BourgeoisLab/MidiCentral/README.md

# MIDI Central
Microcontroller based device to centralize MIDI messages.

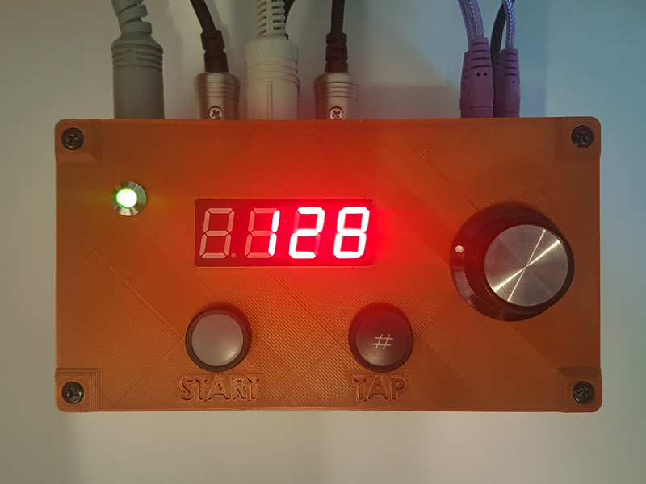
[picture p1: images/01.jpg]
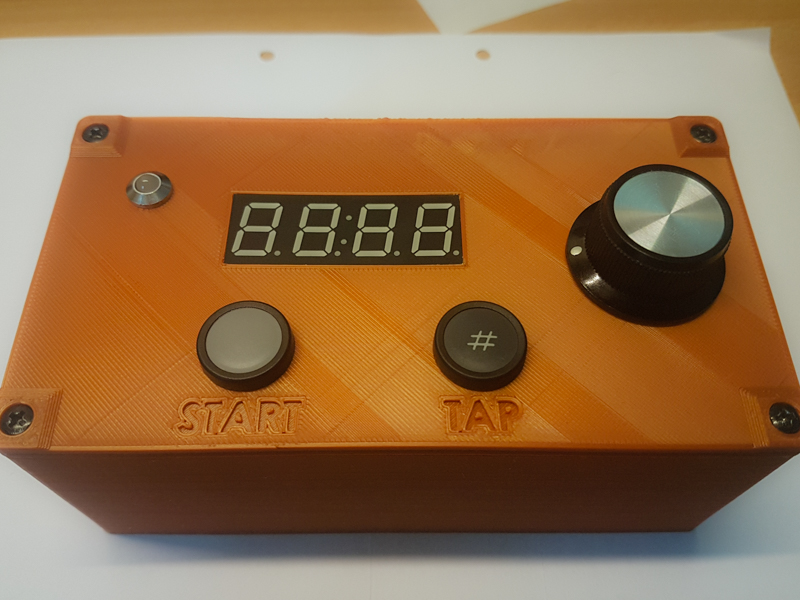
[picture p2: images/02.jpg]
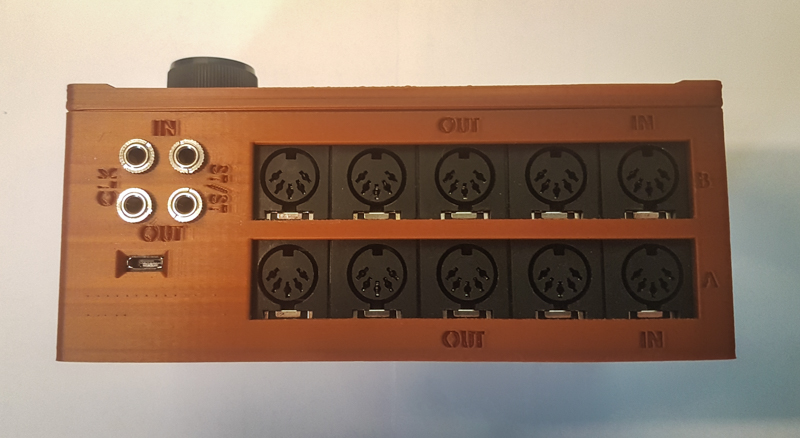
[picture p3: images/03.jpg]
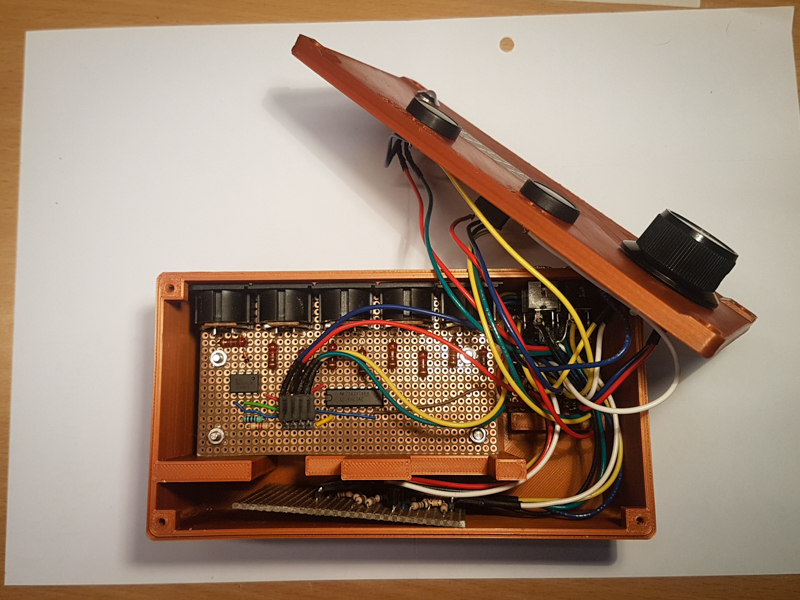
[picture p4: images/04.jpg]
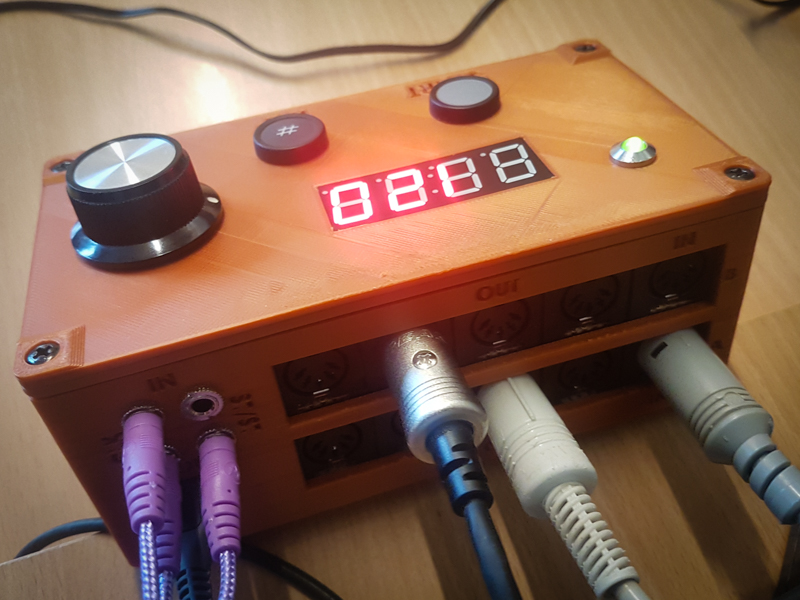
[picture p5: images/05.jpg]


## Features
### Software
- Arduino based code
- Merges up to 3 different MIDI inputs
- MIDI to CV clock converter and vice versa
- Act as a MIDI device when plugged in a computer

### Hardware
- 2x MIDI inputs
- 8x MIDI outputs
- 1x CV clock input and output
- 1x CV start/stop input and output
- 1x start/stop button
- 1x tap button
- 1x encoder
- 1x 4-Digit 7-Segment Display
- Teensy 3.2 (32 bit ARM Cortex-M4 72 MHz CPU)
- USB powered
