BourgeoisLab/MidiCentral/schematics/pinout.png

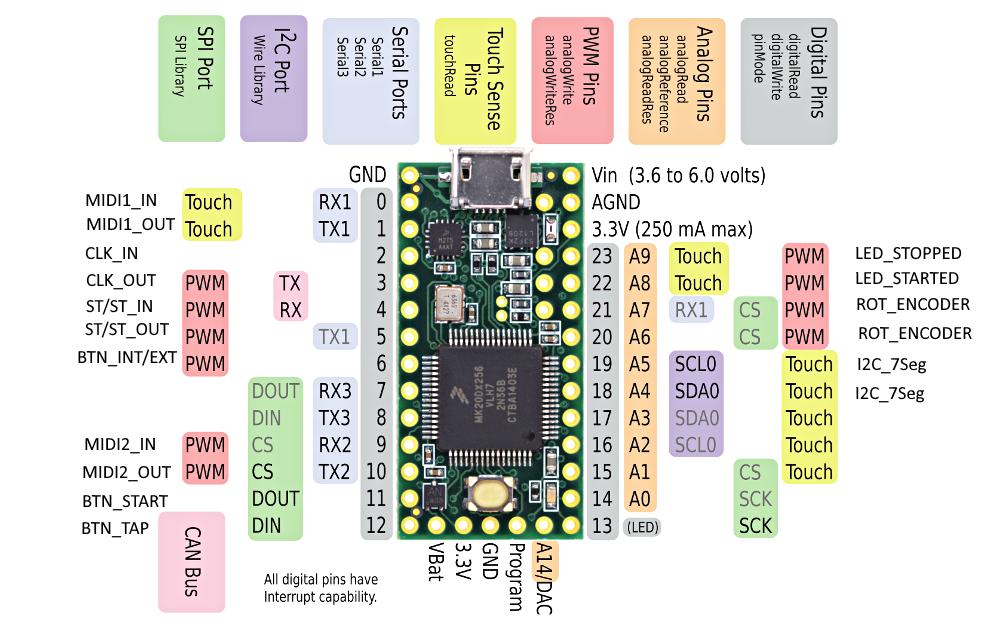
schematics/pinout.png
