BourgeoisLab/MidiCentral/schematics/GateInterface.pdf

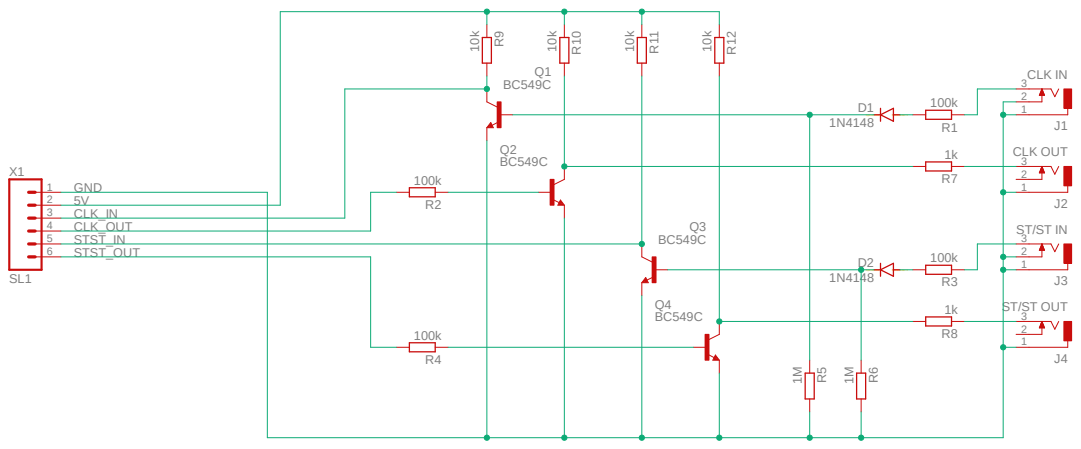
[picture p7: page 1]

Document Number: | REV:

Date: 23.12.2019 15:04 | Sheet: 1/1

23.12.2019 15:05 D:\Downloads\midi\doc\GateInterface.sch (Sheet: 1/1)
