BourgeoisLab/MidiCentral/schematics/MidiInterface.pdf

23.12.2019 15:05 D:\Downloads\midi\doc\MidiInterface.sch (Sheet: 1/1) | SpiceOrder 1 SpiceOrder 2

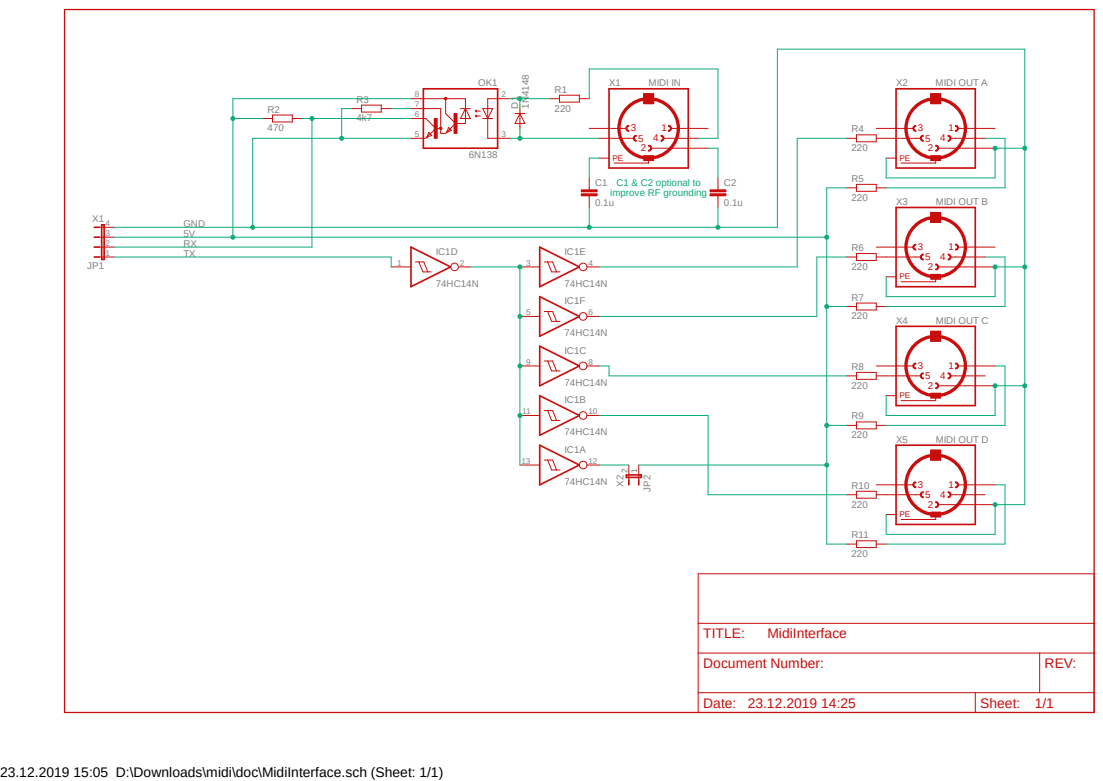
[picture p8: page 1]

Document Number: | REV:

Date: 23.12.2019 14:25 | Sheet: 1/1
