BourgeoisLab/MidiCentral/schematics/GateInterface.sch

## EAGLE design schematics/GateInterface.sch (2020-04-12)

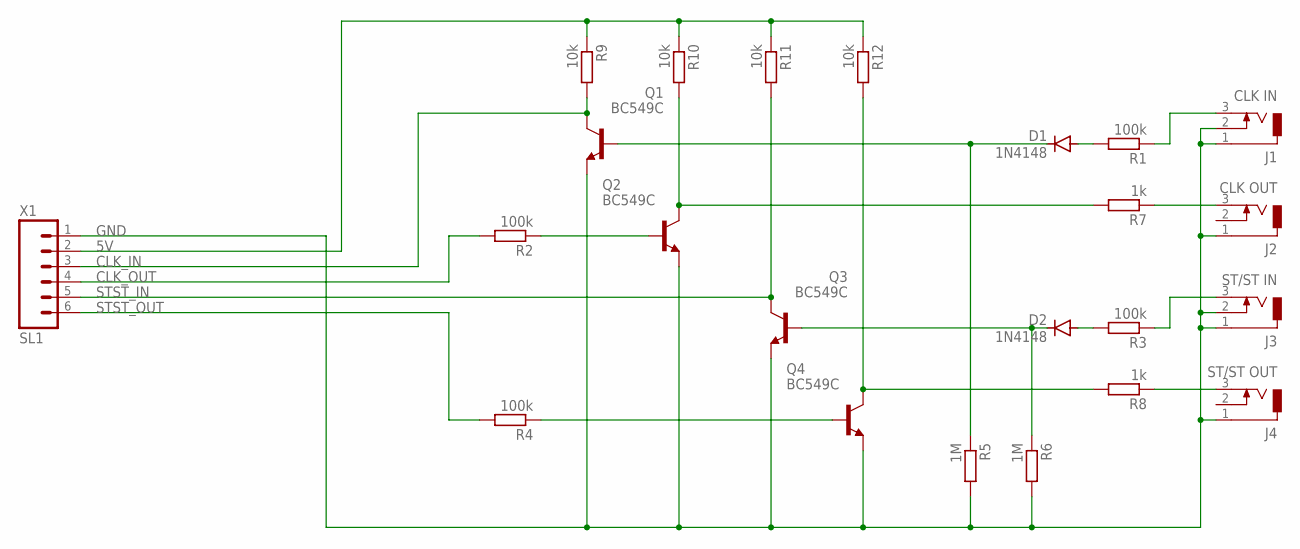
[picture p9: schematic GateInterface.sch]

Parts:
D1, D2: 1N4148; DO35-10
J1: CLK IN; DCJ0202
J2: CLK OUT; DCJ0202
J3: ST/ST IN; DCJ0202
J4: ST/ST OUT; DCJ0202
Q1, Q2, Q3, Q4: BC549C; TO92-EBC
R1, R2, R3, R4: 100k; 0207/10
R5, R6: 1M; 0207/10
R7, R8: 1k; 0207/10
R9, R10, R11, R12: 10k; 0207/10
SL1: X1; 06P

Connections:
5V: R9.1, R10.1, R11.1, R12.1, SL1.2
CLK_IN: Q1.C, R9.2, SL1.3
CLK_OUT: R2.2, SL1.4
GND: J1.1, J1.2, J2.1, J3.1, J3.2, J4.1, Q1.E, Q2.E, Q3.E, Q4.E, R5.2, R6.2, SL1.1
unnamed: J1.3, R1.1
unnamed: J4.3, R8.1
unnamed: J3.3, R3.1
unnamed: D1.A, R1.2
unnamed: D1.C, Q1.B, R5.1
unnamed: D2.C, Q3.B, R6.1
unnamed: D2.A, R3.2
unnamed: Q2.B, R2.1
unnamed: Q4.B, R4.1
unnamed: Q2.C, R7.2, R10.2
unnamed: Q4.C, R8.2, R12.2
unnamed: J2.3, R7.1
STST_IN: Q3.C, R11.2, SL1.5
STST_OUT: R4.2, SL1.6
