BourgeoisLab/MidiCentral/schematics/MidiInterface.sch

## EAGLE design schematics/MidiInterface.sch (2020-04-12)

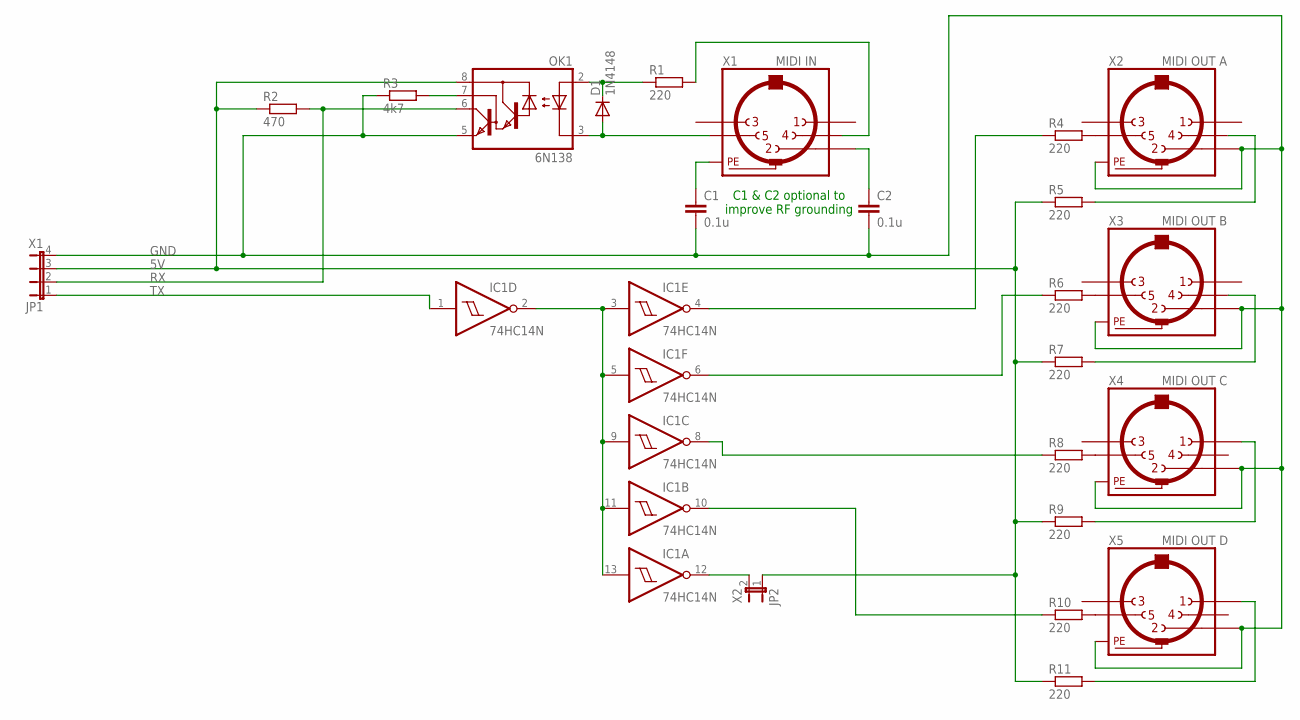
[picture p10: schematic MidiInterface.sch]

Parts:
C1, C2: 0.1u; C025-025X050
D1: 1N4148; DO35-7
IC1: 74HC14N; DIL14
JP1: X1; JP4
JP2: X2; JP1
OK1: 6N138; DIL08
R1, R4, R5, R6, R7, R8, R9, R10, R11: 220; 0204/7
R2: 470; 0204/7
R3: 4k7; 0204/7
X1: MIDI IN; MAB5SH
X2: MIDI OUT A; MAB5SH
X3: MIDI OUT B; MAB5SH
X4: MIDI OUT C; MAB5SH
X5: MIDI OUT D; MAB5SH

Connections:
5V: JP1.3, JP2.1, OK1.8 (VCC), R2.1, R5.1, R7.1, R9.1, R11.1
GND: C1.2, C2.2, JP1.4, OK1.5 (GND), R3.1, X2.2, X2.PE, X3.2, X3.PE, X4.2, X4.PE, X5.2, X5.PE
unnamed: R1.2, X1.4
unnamed: D1.C, OK1.2 (A), R1.1
unnamed: D1.A, OK1.3 (C), X1.5
unnamed: OK1.7 (VB), R3.2
unnamed: R4.2, X2.5
unnamed: R6.2, X3.5
unnamed: R8.2, X4.5
unnamed: R10.2, X5.5
unnamed: R5.2, X2.4
unnamed: R7.2, X3.4
unnamed: R9.2, X4.1
unnamed: R11.2, X5.1
unnamed: IC1.2 (O), IC1.3 (I), IC1.5 (I), IC1.9 (I), IC1.11 (I), IC1.13 (I)
unnamed: IC1.4 (O), R4.1
unnamed: IC1.6 (O), R6.1
unnamed: IC1.8 (O), R8.1
unnamed: IC1.10 (O), R10.1
unnamed: IC1.12 (O), JP2.2
unnamed: C1.1, X1.PE
unnamed: C2.1, X1.2
RX: JP1.2, OK1.6 (VO), R2.2
TX: IC1.1 (I), JP1.1

Notes on the sheet:
C1 & C2 optional to improve RF grounding
